Titper/BE_L3EEAREL_2022/Rapport/Presentation_BE_BUSO_GAY-PUIG.pptx

## Projet be : réalisation d’un drone

L3 EEA REL
Buso lohan / guy-puig antoine

1- Schéma fonctionnel
II- Anatomie du drone
III- Réalisation du drone

## 1- Schéma fonctionnel

Arduino

Commande

Radio - télécommande

RF 2.4 Ghz

Récepteur RF

4

4

ESC

4

Moteur Brushless

PWM

PWM

Triphasé

Stabilisation

Capteur Gyroscopique

I2C

## II- Anatomie du drone

- ESC / Moteurs brushless

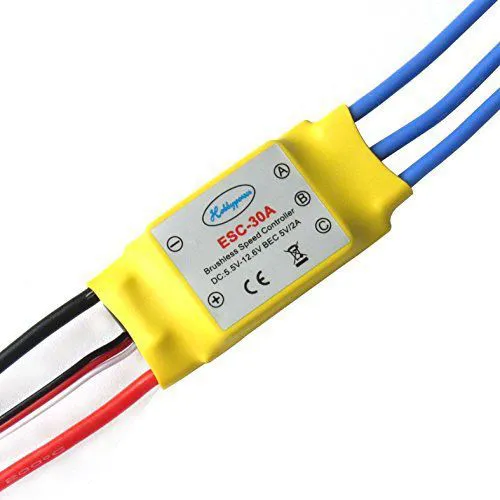
[picture p1: figure]
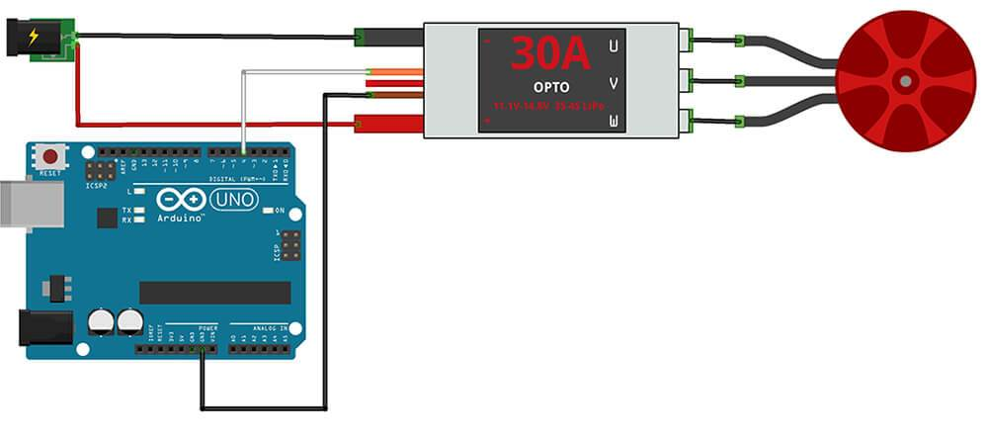
[picture p2: figure]

## II- Anatomie du drone

- ESC / Moteurs brushless

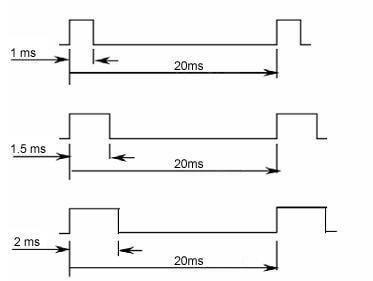
[picture p3: figure]

Notes: Explication pwm

## II- Anatomie du drone

- Radio-télécommande / Récepteur RF

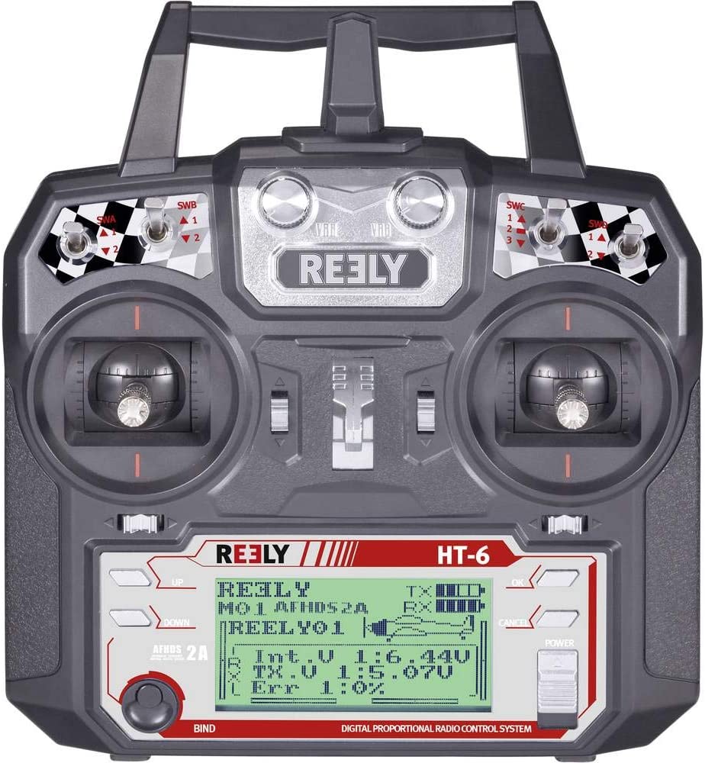
[picture p4: figure]
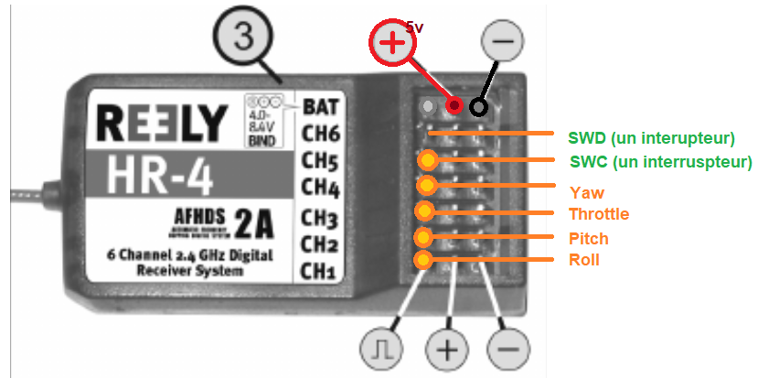
[picture p5: figure]
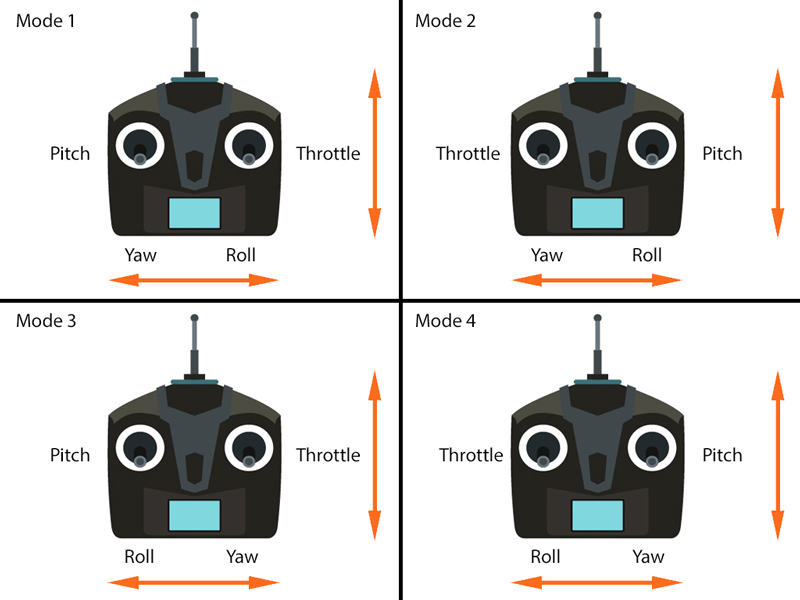
[picture p6: figure]

## II- Anatomie du drone

- Radio-télécommande / Récepteur RF

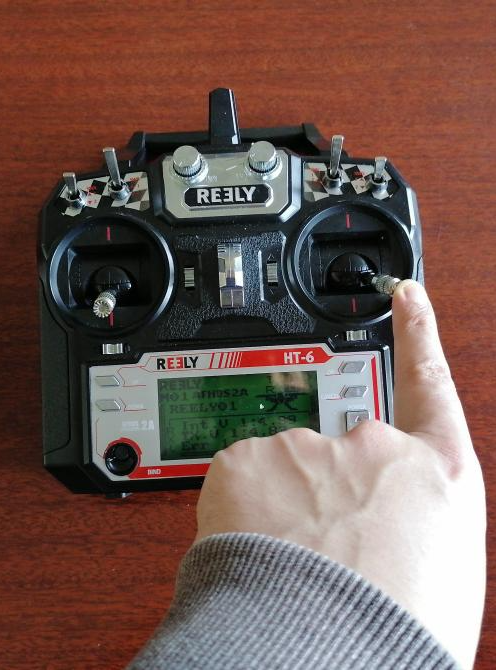
[picture p7: figure]
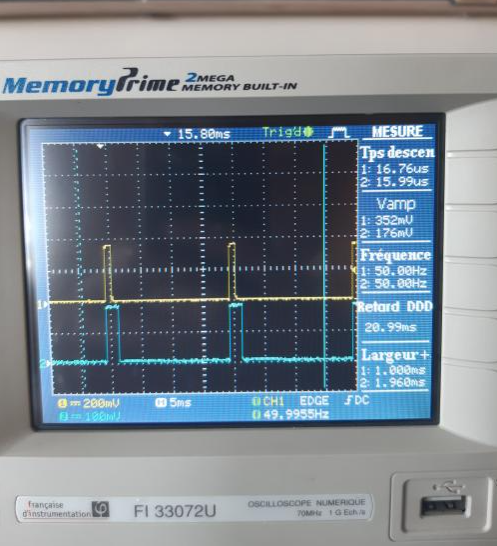
[picture p8: figure]
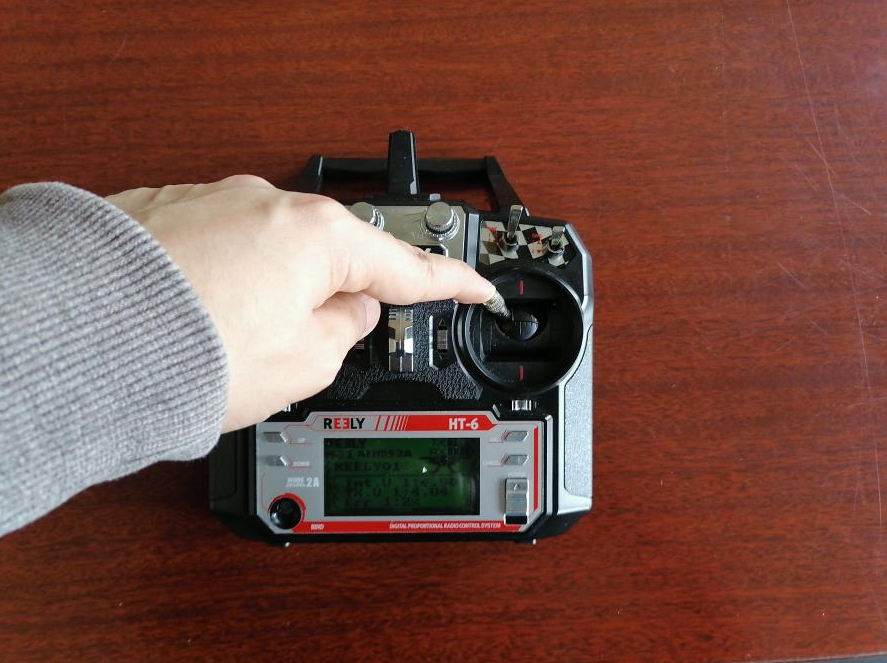
[picture p9: figure]
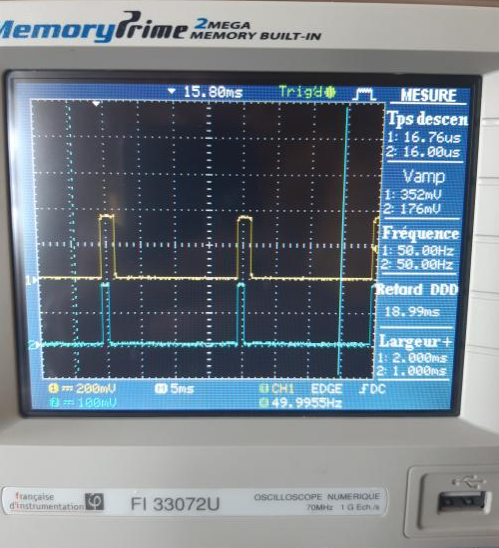
[picture p10: figure]

## II- Anatomie du drone

- Capteur MPU6050
  - Tension d’alimentation : entre 2.375V et 3.45V
  - Utilisation des interruptions
  - Communication bus I2C
  - Gyroscope :
    - Précision : ±2000°/sec
    - Consommation nominale : 3.6mA
  - Accéléromètre :
    - Précision : ±16g
    - Consommation nominale : 500µA

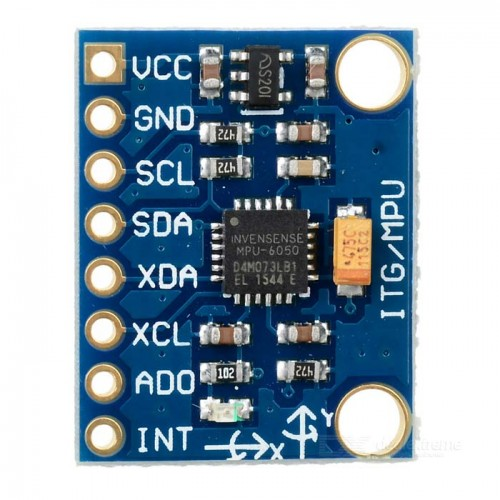
[picture p11: figure]

## III- réalisation du drone

- Utilisation et calibration des ESC

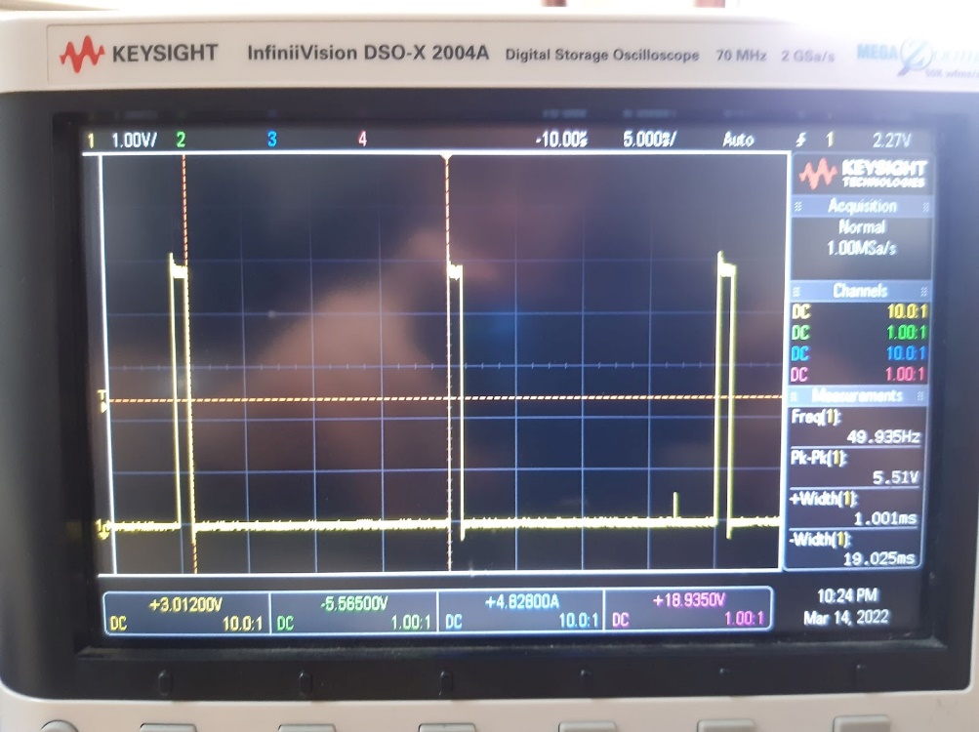
[picture p12: figure]
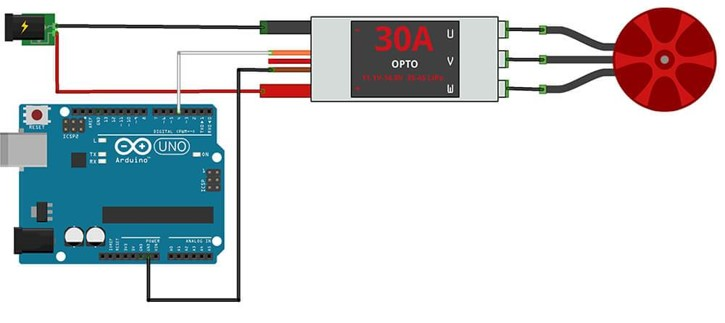
[picture p13: figure]

## III- réalisation du drone

- Calibration/exploitation du capteur gyroscopique MPU6050

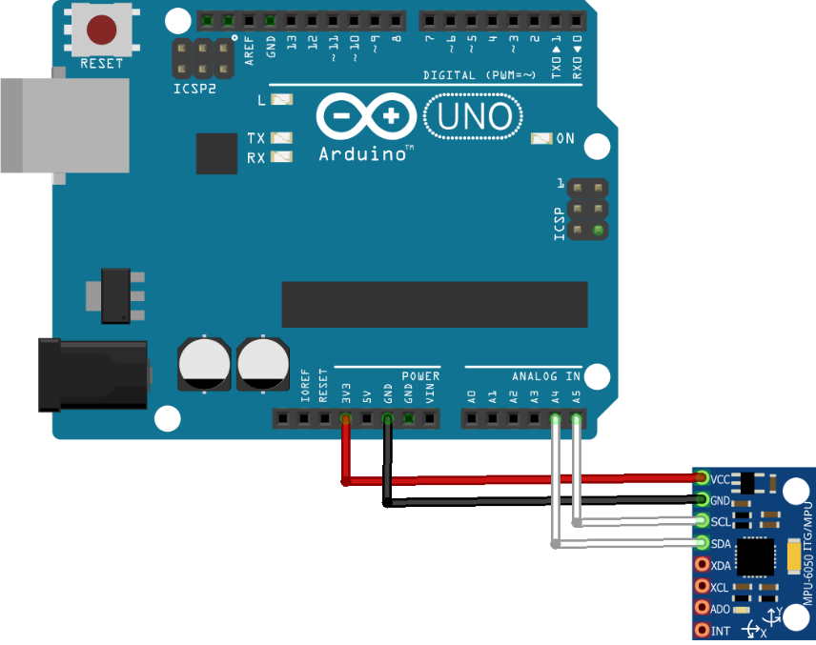
[picture p14: figure]
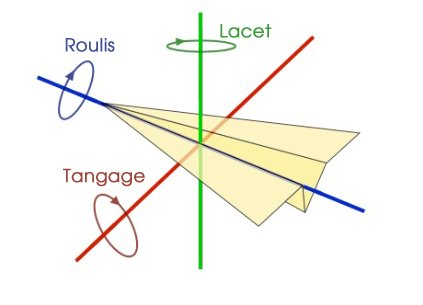
[picture p15: figure]

## III- réalisation du drone

- Utilisation radio-télécommande et récepteur RF

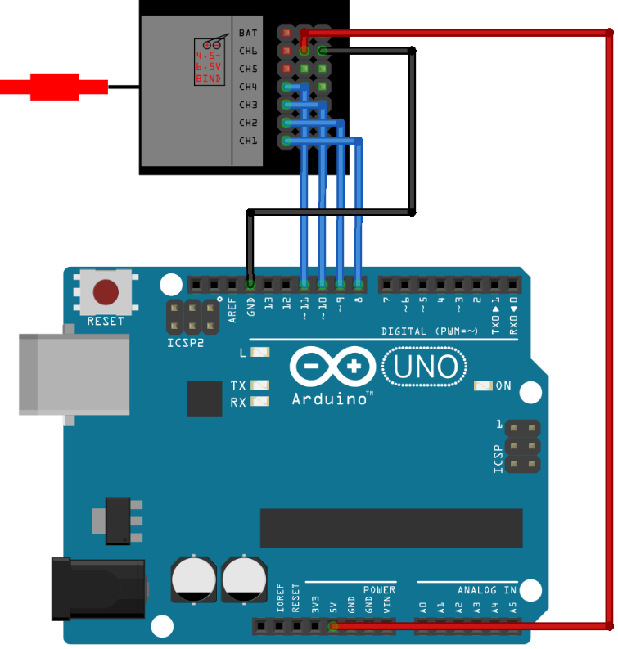
[picture p16: figure]
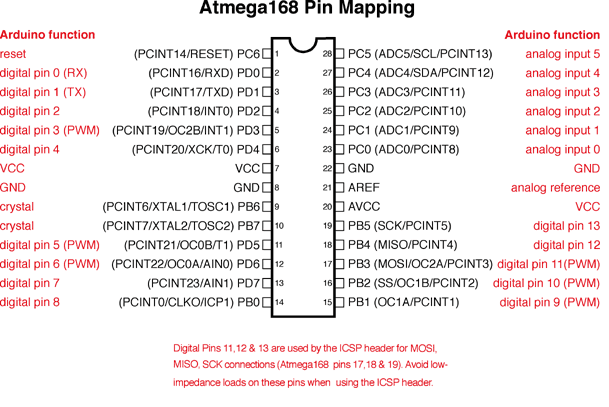
[picture p17: figure]

## III- réalisation du drone

- Utilisation radio-télécommande et récepteur RF

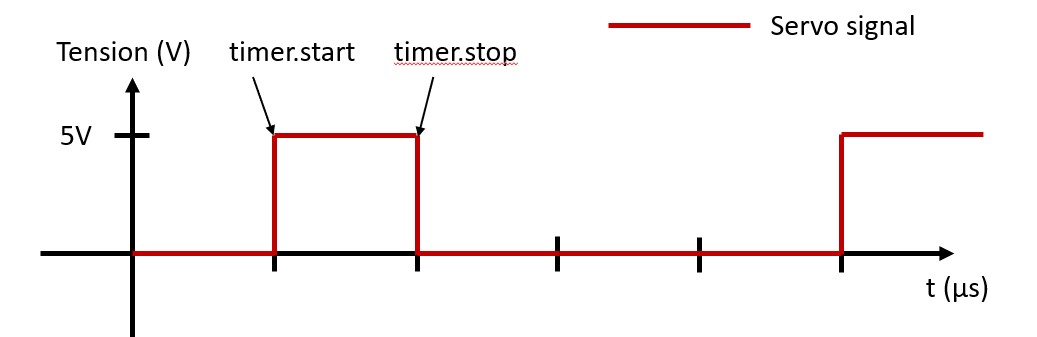
[picture p18: figure]

## III- réalisation du drone

- Régulateur PID

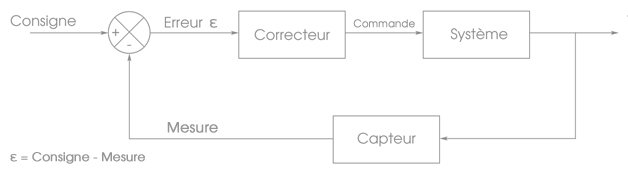
[picture p19: figure]

## III- réalisation du drone

- Régulateur PID

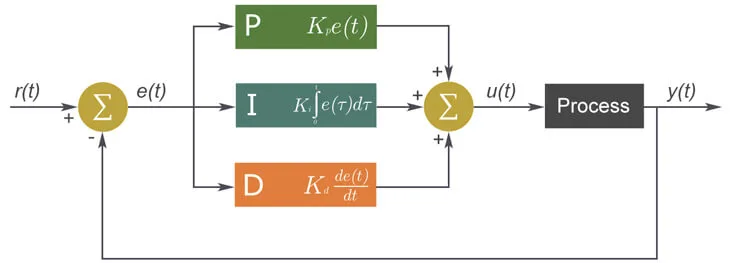
[picture p20: figure]

u(t)=K_p e(t)+K_i ∫_0^t e(t)dt+K_d (de(t))/(dt)

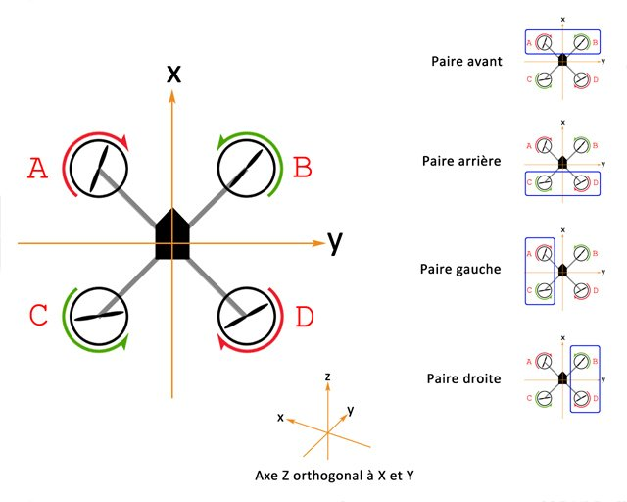
[picture p21: figure]

## Conclusion

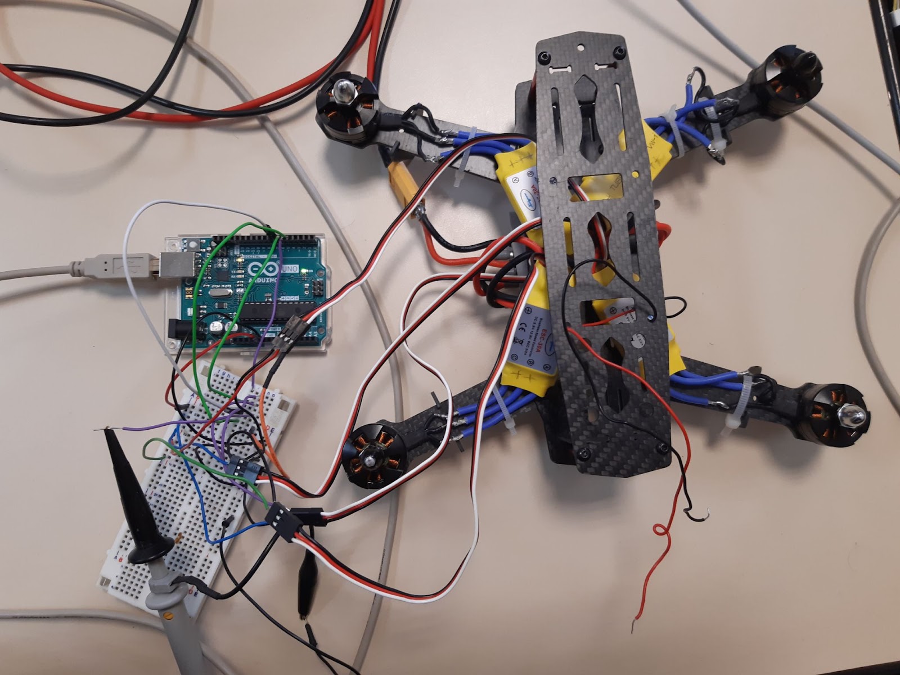
[picture p22: figure]
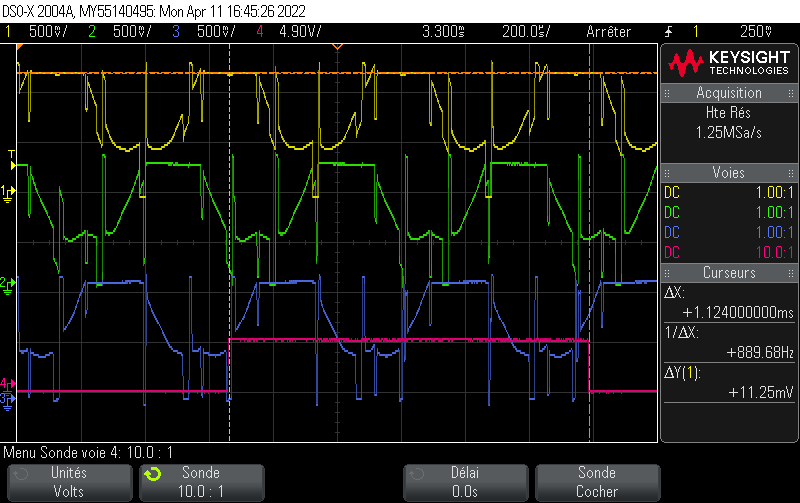
[picture p23: figure]

## Merci de votre attention

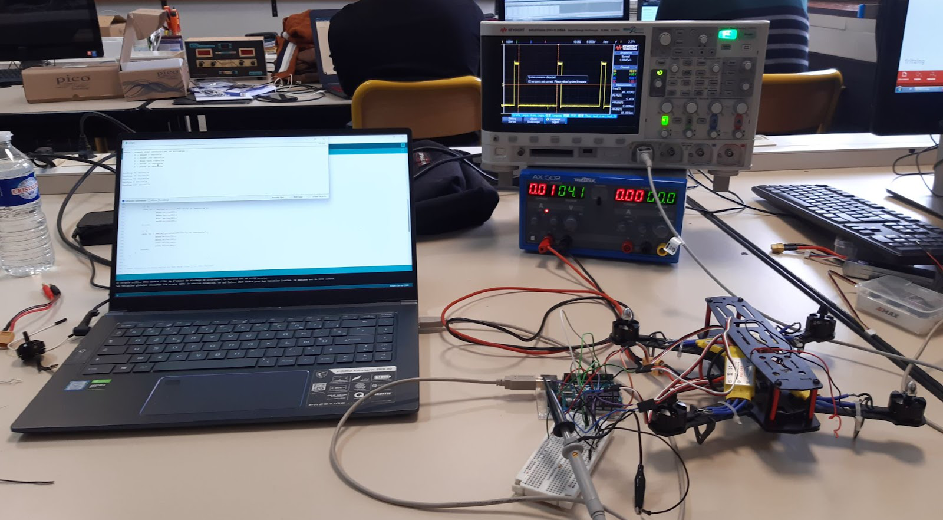
[picture p24: figure]

AVEZ-VOUS des Question ?
