Titper/BE_L3EEAREL_2022/brouilllon paint.png

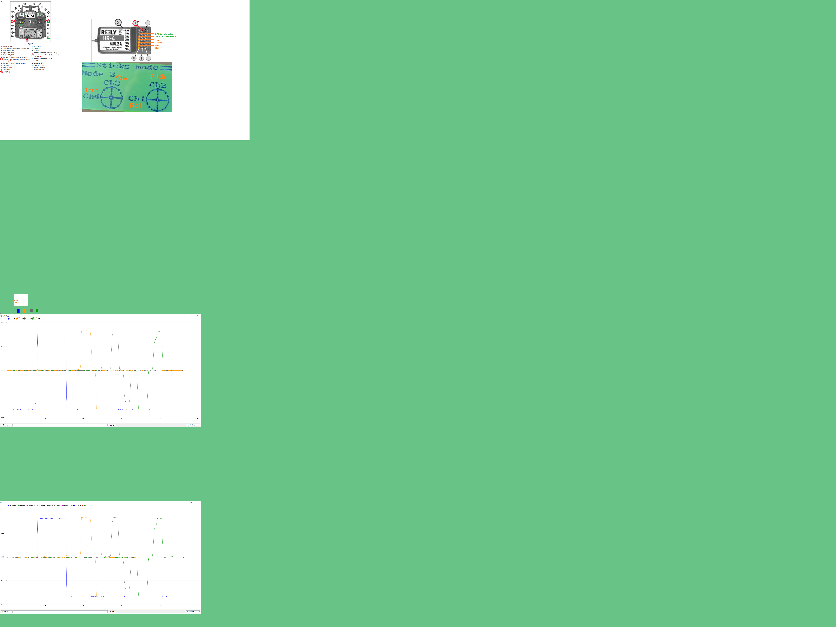
brouilllon paint.png
