Titper/BE_L3EEAREL_2022/Fritzing/Schéma capteur distance_bb.png

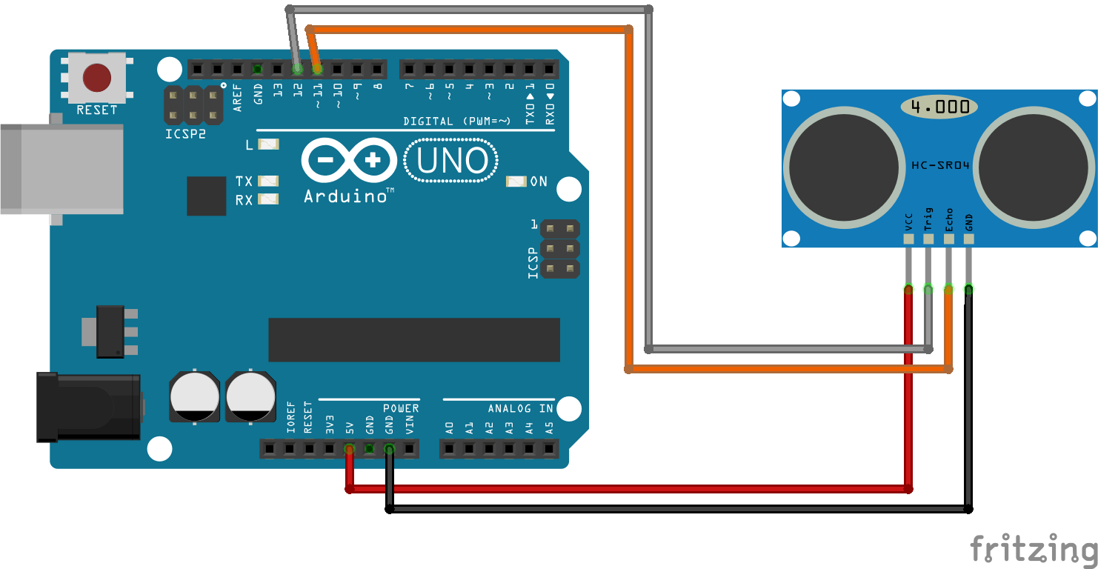
Fritzing/Schéma capteur distance_bb.png
