Titper/BE_L3EEAREL_2022/Fritzing/Schéma écran LCD_schéma.png

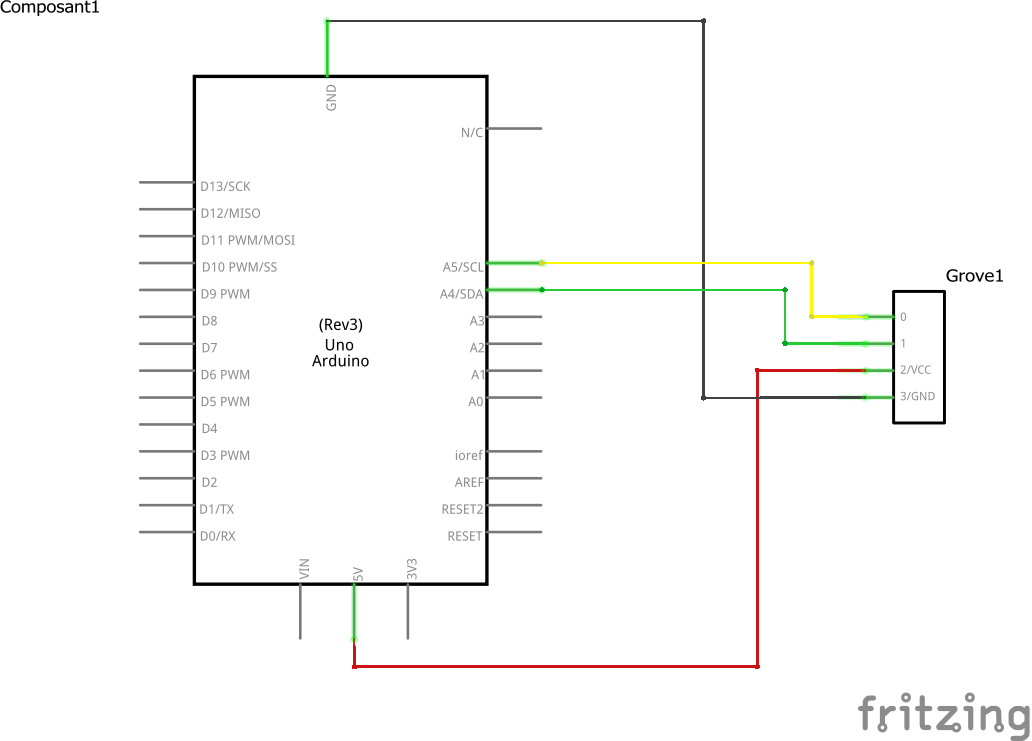
Fritzing/Schéma écran LCD_schéma.png
