Titper/BE_L3EEAREL_2022/(list of files, drawings)

Other design files:
Fritzing/Schéma capteur distance + LCD.fzz
Fritzing/Schéma capteur distance.fzz
Fritzing/Schéma écran LCD.fzz
